charliemcohen/hab/photos/07_ground_test_rig.jpg

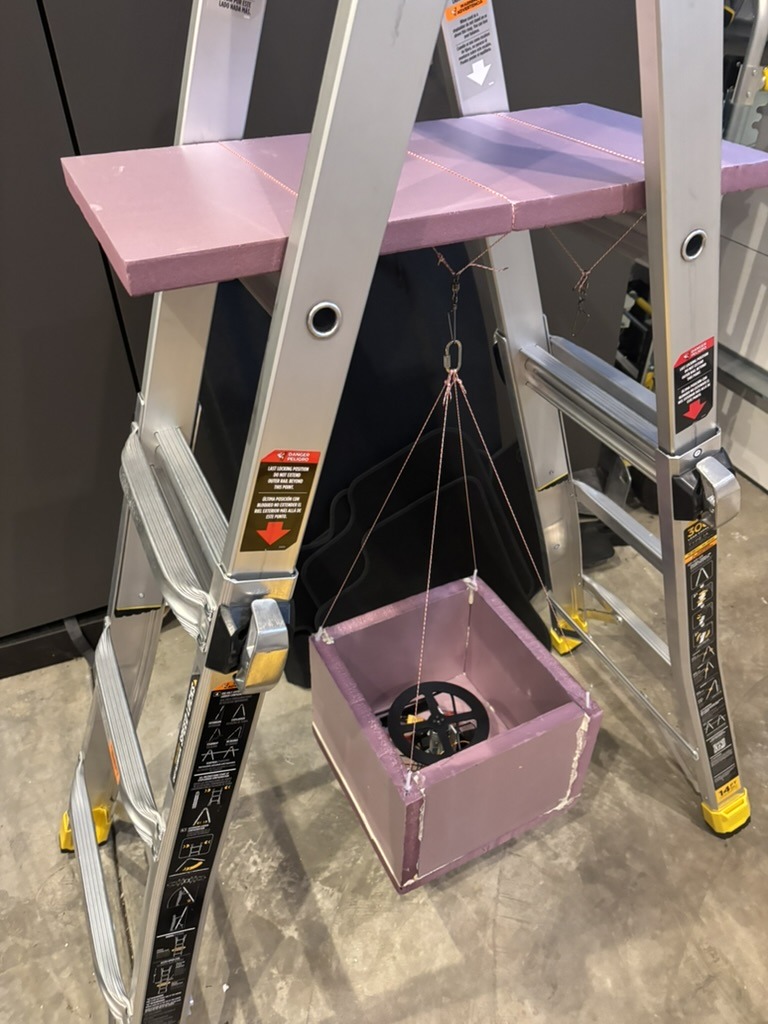
photos/07_ground_test_rig.jpg
