charliemcohen/hab/photos/05_electronics_closeup.jpg

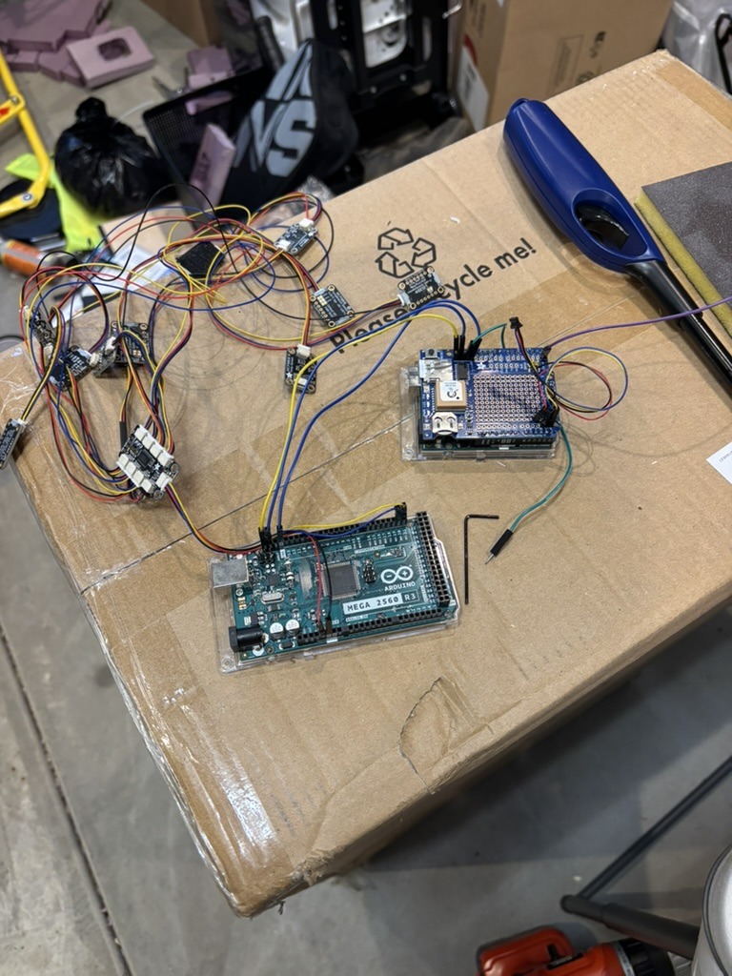
photos/05_electronics_closeup.jpg
