charliemcohen/hab/docs/figures/fig07_temperature_vs_altitude.png

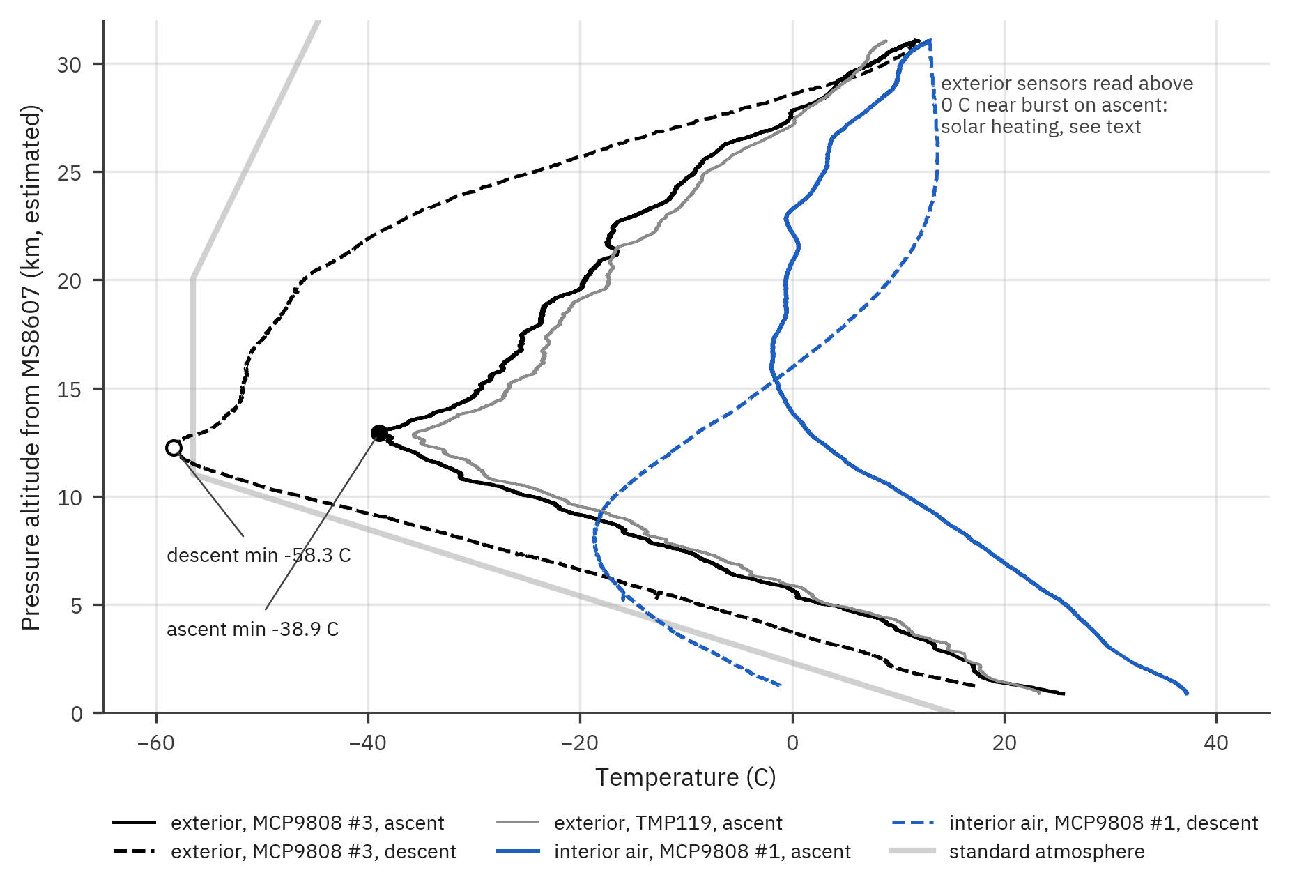
docs/figures/fig07_temperature_vs_altitude.png
