charliemcohen/hab/docs/figures/fig08_wind_vs_altitude.png

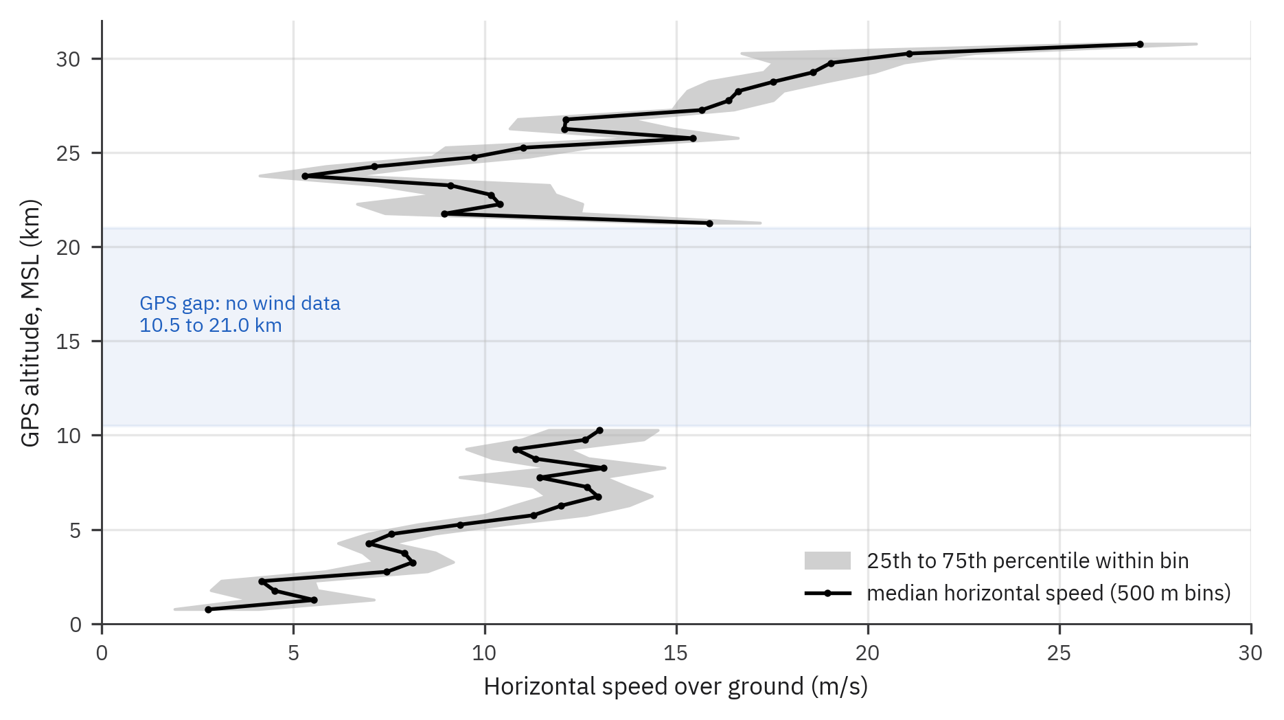
docs/figures/fig08_wind_vs_altitude.png
