charliemcohen/hab/docs/figures/fig11_light_uv_vs_altitude.png

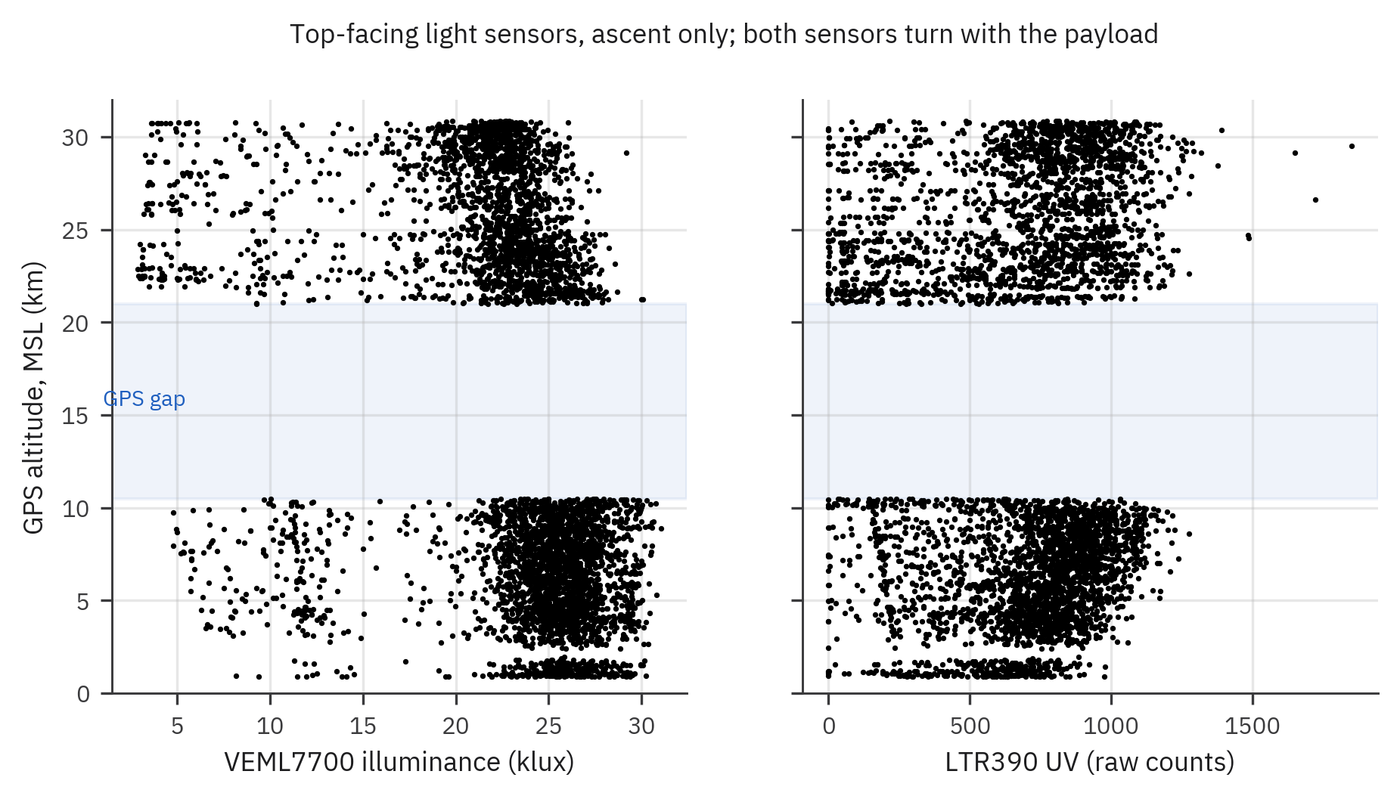
docs/figures/fig11_light_uv_vs_altitude.png
