charliemcohen/hab/photos/12_recovery_photo.jpg

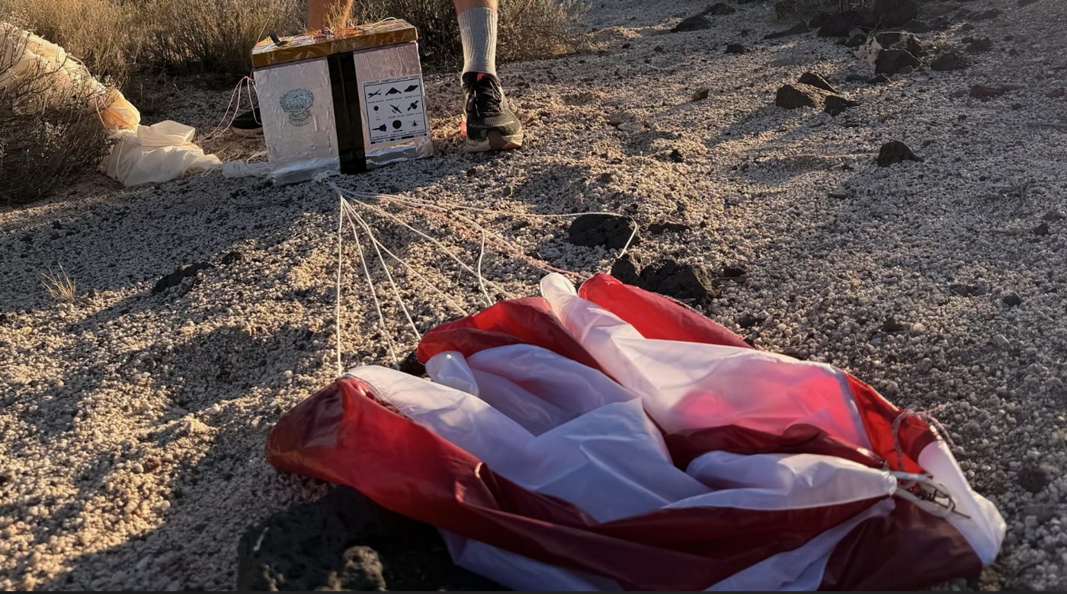
photos/12_recovery_photo.jpg
