charliemcohen/hab/rotation_results/Flight_2_rotation.csv

window | center | t_min | result | yaw_rate_dps | rot_per_min | method | repeat_period_s | repeat_strength | rpm_from_motion | implied_hfov_deg | swing_amplitude_deg | swing_period_s | direction | notes | plot
+0 min | 0:02:44.9 | 0.0 | swinging | 0.354 | 0.06 | net drift from frame motion, assumes hfov=120 deg | 4.45 | 0.52 | 0.06 |  | 28.3 | 102.0 | scene drifts right | 59% of frame pairs matched poorly (glare, blur, or tumbling) | rotation_results\Flight_2__0_min.png
+1 min | 0:02:49.9 | 1.0 | mixed | 0.506 | 0.08 | net drift from frame motion, assumes hfov=120 deg |  |  | 0.08 |  | 8.2 | 72.7 | scene drifts right | 100% of frame pairs matched poorly (glare, blur, or tumbling) | rotation_results\Flight_2__1_min.png
+2 min | 0:02:54.9 | 2.0 | nearly steady | 0.322 | 0.05 | frame motion, assumes hfov=120 deg | 38.46 | 0.48 | 0.05 |  | 9.2 | 179.9 | scene drifts right | 100% of frame pairs matched poorly (glare, blur, or tumbling) | rotation_results\Flight_2__2_min.png
+3 min | 0:02:59.9 | 3.0 | nearly steady | -0.118 | 0.02 | frame motion, assumes hfov=120 deg |  |  | 0.02 |  | 5.4 | 175.4 | scene drifts left | 100% of frame pairs matched poorly (glare, blur, or tumbling) | rotation_results\Flight_2__3_min.png
+4 min | 0:03:04.9 | 4.0 | nearly steady | -0.323 | 0.05 | frame motion, assumes hfov=120 deg | 50.33 | 0.72 | 0.05 |  | 5.1 | 56.7 | scene drifts left | 100% of frame pairs matched poorly (glare, blur, or tumbling) | rotation_results\Flight_2__4_min.png
+5 min | 0:03:09.9 | 5.0 | nearly steady | -0.05 | 0.01 | frame motion, assumes hfov=120 deg | 10.02 | 0.46 | 0.01 |  | 7.9 | 463.7 | scene drifts left | 100% of frame pairs matched poorly (glare, blur, or tumbling) | rotation_results\Flight_2__5_min.png
+6 min | 0:03:14.9 | 6.0 | nearly steady | 0.094 | 0.02 | frame motion, assumes hfov=120 deg |  |  | 0.02 |  | 4.9 | 81.9 | scene drifts right | 100% of frame pairs matched poorly (glare, blur, or tumbling) | rotation_results\Flight_2__6_min.png
+7 min | 0:03:19.9 | 7.0 | mixed | -0.34 | 0.06 | net drift from frame motion, assumes hfov=120 deg | 18.3 | 0.61 | 0.06 |  | 7.0 | 90.2 | scene drifts left | 100% of frame pairs matched poorly (glare, blur, or tumbling) | rotation_results\Flight_2__7_min.png
+8 min | 0:03:24.9 | 8.0 | nearly steady | -0.185 | 0.03 | frame motion, assumes hfov=120 deg |  |  | 0.03 |  | 4.2 | 22.3 | scene drifts left | 100% of frame pairs matched poorly (glare, blur, or tumbling) | rotation_results\Flight_2__8_min.png
+9 min | 0:03:29.9 | 9.0 | nearly steady | -0.094 | 0.02 | frame motion, assumes hfov=120 deg |  |  | 0.02 |  | 3.6 | 165.9 | scene drifts left | 100% of frame pairs matched poorly (glare, blur, or tumbling) | rotation_results\Flight_2__9_min.png
+10 min | 0:03:34.9 | 10.0 | nearly steady | 0.105 | 0.02 | frame motion, assumes hfov=120 deg | 51.53 | 0.49 | 0.02 |  | 5.4 | 38.6 | scene drifts right | 100% of frame pairs matched poorly (glare, blur, or tumbling) | rotation_results\Flight_2__10_min.png
+11 min | 0:03:39.9 | 11.0 | nearly steady | 0.148 | 0.02 | frame motion, assumes hfov=120 deg | 43.81 | 0.48 | 0.02 |  | 9.4 | 79.6 | scene drifts right | 100% of frame pairs matched poorly (glare, blur, or tumbling) | rotation_results\Flight_2__11_min.png
+12 min | 0:03:44.9 | 12.0 | nearly steady | -0.041 | 0.01 | frame motion, assumes hfov=120 deg |  |  | 0.01 |  | 7.7 | 170.6 | scene drifts left | 100% of frame pairs matched poorly (glare, blur, or tumbling) | rotation_results\Flight_2__12_min.png
+13 min | 0:03:49.9 | 13.0 | nearly steady | -0.15 | 0.02 | frame motion, assumes hfov=120 deg | 18.11 | 0.62 | 0.02 |  | 5.8 | 197.4 | scene drifts left | 100% of frame pairs matched poorly (glare, blur, or tumbling) | rotation_results\Flight_2__13_min.png
+14 min | 0:03:54.9 | 14.0 | nearly steady | -0.259 | 0.04 | frame motion, assumes hfov=120 deg | 49.62 | 0.68 | 0.04 |  | 5.5 | 34.2 | scene drifts left | 100% of frame pairs matched poorly (glare, blur, or tumbling) | rotation_results\Flight_2__14_min.png
+15 min | 0:03:59.9 | 15.0 | mixed | -0.401 | 0.07 | net drift from frame motion, assumes hfov=120 deg | 47.05 | 0.52 | 0.07 |  | 3.1 | 32.2 | scene drifts left | 100% of frame pairs matched poorly (glare, blur, or tumbling) | rotation_results\Flight_2__15_min.png
+16 min | 0:04:04.9 | 16.0 | nearly steady | 0.061 | 0.01 | frame motion, assumes hfov=120 deg | 40.36 | 0.61 | 0.01 |  | 8.9 | 145.8 | scene drifts right | 100% of frame pairs matched poorly (glare, blur, or tumbling) | rotation_results\Flight_2__16_min.png
+17 min | 0:04:09.9 | 17.0 | nearly steady | 0.097 | 0.02 | frame motion, assumes hfov=120 deg |  |  | 0.02 |  | 5.1 | 32.6 | scene drifts right | 100% of frame pairs matched poorly (glare, blur, or tumbling) | rotation_results\Flight_2__17_min.png
+18 min | 0:04:14.9 | 18.0 | nearly steady | -0.289 | 0.05 | frame motion, assumes hfov=120 deg | 41.61 | 0.51 | 0.05 |  | 4.1 | 209.3 | scene drifts left | 100% of frame pairs matched poorly (glare, blur, or tumbling) | rotation_results\Flight_2__18_min.png
+19 min | 0:04:19.9 | 19.0 | nearly steady | 0.096 | 0.02 | frame motion, assumes hfov=120 deg | 50.11 | 0.69 | 0.02 |  | 8.5 | 147.1 | scene drifts right | 100% of frame pairs matched poorly (glare, blur, or tumbling) | rotation_results\Flight_2__19_min.png
+20 min | 0:04:24.9 | 20.0 | nearly steady | 0.166 | 0.03 | frame motion, assumes hfov=120 deg | 43.87 | 0.72 | 0.03 |  | 4.9 | 117.8 | scene drifts right | 100% of frame pairs matched poorly (glare, blur, or tumbling) | rotation_results\Flight_2__20_min.png
+21 min | 0:04:29.9 | 21.0 | nearly steady | 0.278 | 0.05 | frame motion, assumes hfov=120 deg |  |  | 0.05 |  | 5.8 | 102.1 | scene drifts right | 100% of frame pairs matched poorly (glare, blur, or tumbling) | rotation_results\Flight_2__21_min.png
+22 min | 0:04:34.9 | 22.0 | nearly steady | 0.059 | 0.01 | frame motion, assumes hfov=120 deg | 57.01 | 0.54 | 0.01 |  | 7.8 | 85.5 | scene drifts right | 100% of frame pairs matched poorly (glare, blur, or tumbling) | rotation_results\Flight_2__22_min.png
+23 min | 0:04:39.9 | 23.0 | mixed | 0.405 | 0.07 | net drift from frame motion, assumes hfov=120 deg | 28.6 | 0.47 | 0.07 |  | 3.9 | 77.5 | scene drifts right | 100% of frame pairs matched poorly (glare, blur, or tumbling) | rotation_results\Flight_2__23_min.png
+24 min | 0:04:44.9 | 24.0 | nearly steady | 0.026 | 0.0 | frame motion, assumes hfov=120 deg |  |  | 0.0 |  | 6.9 | 69.5 | scene drifts right | 100% of frame pairs matched poorly (glare, blur, or tumbling) | rotation_results\Flight_2__24_min.png
+25 min | 0:04:49.9 | 25.0 | nearly steady | 0.141 | 0.02 | frame motion, assumes hfov=120 deg | 16.36 | 0.53 | 0.02 |  | 5.7 | 98.8 | scene drifts right | 100% of frame pairs matched poorly (glare, blur, or tumbling) | rotation_results\Flight_2__25_min.png
+26 min | 0:04:54.9 | 26.0 | nearly steady | -0.269 | 0.04 | frame motion, assumes hfov=120 deg |  |  | 0.04 |  | 9.7 | 97.0 | scene drifts left | 100% of frame pairs matched poorly (glare, blur, or tumbling) | rotation_results\Flight_2__26_min.png
+27 min | 0:04:59.9 | 27.0 | mixed | 0.175 | 0.03 | net drift from frame motion, assumes hfov=120 deg | 27.82 | 0.46 | 0.03 |  | 11.3 | 148.4 | scene drifts right | 100% of frame pairs matched poorly (glare, blur, or tumbling) | rotation_results\Flight_2__27_min.png
+28 min | 0:05:04.9 | 28.0 | swinging | -0.102 | 0.02 | net drift from frame motion, assumes hfov=120 deg | 17.64 | 0.47 | 0.02 |  | 10.1 | 282.5 | scene drifts left | 100% of frame pairs matched poorly (glare, blur, or tumbling) | rotation_results\Flight_2__28_min.png
+29 min | 0:05:09.9 | 29.0 | swinging | -0.053 | 0.01 | net drift from frame motion, assumes hfov=120 deg |  |  | 0.01 |  | 11.1 | 247.0 | scene drifts left | 100% of frame pairs matched poorly (glare, blur, or tumbling) | rotation_results\Flight_2__29_min.png
+30 min | 0:05:14.9 | 30.0 | nearly steady | 0.312 | 0.05 | frame motion, assumes hfov=120 deg | 25.96 | 0.49 | 0.05 |  | 4.5 | 29.4 | scene drifts right | 100% of frame pairs matched poorly (glare, blur, or tumbling) | rotation_results\Flight_2__30_min.png
