charliemcohen/hab/rotation_results/Flight_2_upper_rotation.csv

window | center | t_min | result | yaw_rate_dps | rot_per_min | method | repeat_period_s | repeat_strength | rpm_from_motion | implied_hfov_deg | swing_amplitude_deg | swing_period_s | direction | notes | plot
+30 min | 0:05:14.9 | 30.0 | nearly steady | 0.312 | 0.05 | frame motion, assumes hfov=120 deg | 25.96 | 0.49 | 0.05 |  | 4.5 | 29.4 | scene drifts right | 100% of frame pairs matched poorly (glare, blur, or tumbling) | rotation_results\Flight_2_upper__30_min.png
+35 min | 0:05:39.9 | 35.0 | mixed | -0.325 | 0.05 | net drift from frame motion, assumes hfov=120 deg | 47.28 | 0.48 | 0.05 |  | 13.1 | 273.6 | scene drifts left | 100% of frame pairs matched poorly (glare, blur, or tumbling) | rotation_results\Flight_2_upper__35_min.png
+40 min | 0:06:04.9 | 40.0 | swinging | -0.171 | 0.03 | net drift from frame motion, assumes hfov=120 deg |  |  | 0.03 |  | 10.3 | 271.7 | scene drifts left | 100% of frame pairs matched poorly (glare, blur, or tumbling) | rotation_results\Flight_2_upper__40_min.png
+45 min | 0:06:29.9 | 45.0 | swinging | -0.235 | 0.04 | net drift from frame motion, assumes hfov=120 deg | 29.74 | 0.49 | 0.04 |  | 12.1 | 644.5 | scene drifts left | 100% of frame pairs matched poorly (glare, blur, or tumbling) | rotation_results\Flight_2_upper__45_min.png
+50 min | 0:06:54.9 | 50.0 | nearly steady | -0.116 | 0.02 | frame motion, assumes hfov=120 deg | 5.83 | 0.65 | 0.02 |  | 5.3 | 86.1 | scene drifts left | 100% of frame pairs matched poorly (glare, blur, or tumbling) | rotation_results\Flight_2_upper__50_min.png
+55 min | 0:07:19.9 | 55.0 | nearly steady | -0.053 | 0.01 | frame motion, assumes hfov=120 deg |  |  | 0.01 |  | 8.0 | 174.4 | scene drifts left | 100% of frame pairs matched poorly (glare, blur, or tumbling) | rotation_results\Flight_2_upper__55_min.png
+60 min | 0:07:44.9 | 60.0 | mixed | -0.374 | 0.06 | net drift from frame motion, assumes hfov=120 deg | 34.27 | 0.82 | 0.06 |  | 3.6 | 38.7 | scene drifts left | 100% of frame pairs matched poorly (glare, blur, or tumbling) | rotation_results\Flight_2_upper__60_min.png
+65 min | 0:08:09.9 | 65.0 | nearly steady | 0.025 | 0.0 | frame motion, assumes hfov=120 deg |  |  | 0.0 |  | 5.0 | 52.3 | scene drifts right | 100% of frame pairs matched poorly (glare, blur, or tumbling) | rotation_results\Flight_2_upper__65_min.png
+70 min | 0:08:34.9 | 70.0 | nearly steady | 0.001 | 0.0 | frame motion, assumes hfov=120 deg | 51.12 | 0.51 | 0.0 |  | 9.0 | 185.0 | scene drifts right | 100% of frame pairs matched poorly (glare, blur, or tumbling) | rotation_results\Flight_2_upper__70_min.png
+75 min | 0:08:59.9 | 75.0 | nearly steady | -0.11 | 0.02 | frame motion, assumes hfov=120 deg |  |  | 0.02 |  | 4.4 | 124.3 | scene drifts left | 100% of frame pairs matched poorly (glare, blur, or tumbling) | rotation_results\Flight_2_upper__75_min.png
+80 min | 0:09:24.9 | 80.0 | mixed | -0.358 | 0.06 | net drift from frame motion, assumes hfov=120 deg |  |  | 0.06 |  | 8.9 | 183.2 | scene drifts left | 100% of frame pairs matched poorly (glare, blur, or tumbling) | rotation_results\Flight_2_upper__80_min.png
+85 min | 0:09:49.9 | 85.0 | nearly steady | 0.073 | 0.01 | frame motion, assumes hfov=120 deg |  |  | 0.01 |  | 3.0 | 70.7 | scene drifts right | 100% of frame pairs matched poorly (glare, blur, or tumbling) | rotation_results\Flight_2_upper__85_min.png
+90 min | 0:10:14.9 | 90.0 | nearly steady | -0.034 | 0.01 | frame motion, assumes hfov=120 deg |  |  | 0.01 |  | 4.3 | 117.2 | scene drifts left | 100% of frame pairs matched poorly (glare, blur, or tumbling) | rotation_results\Flight_2_upper__90_min.png
+95 min | 0:10:39.9 | 95.0 | nearly steady | 0.282 | 0.05 | frame motion, assumes hfov=120 deg | 40.47 | 0.73 | 0.05 |  | 3.4 | 40.6 | scene drifts right | 100% of frame pairs matched poorly (glare, blur, or tumbling) | rotation_results\Flight_2_upper__95_min.png
