charliemcohen/hab/rotation_results/Flight_2__4_min.png

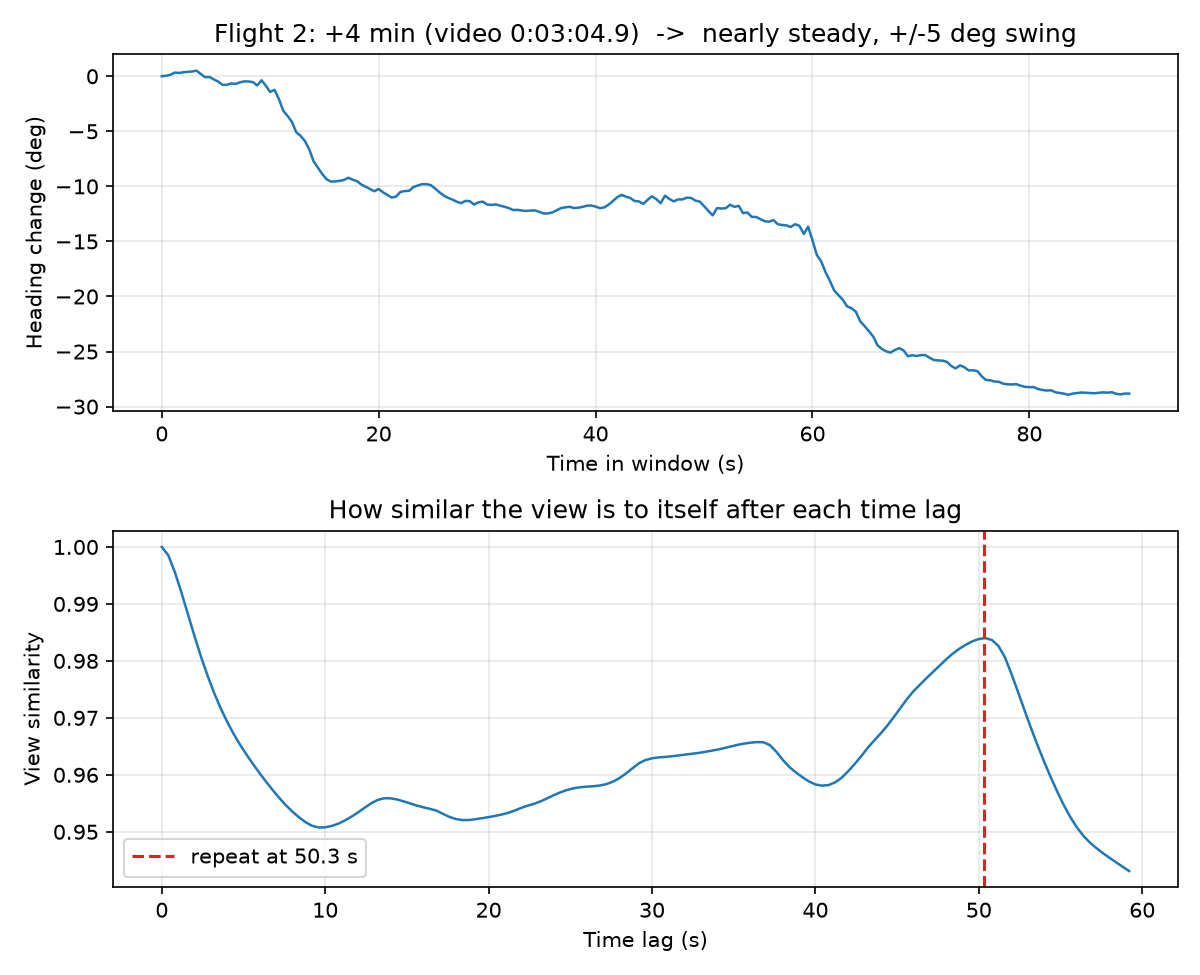
rotation_results/Flight_2__4_min.png
