charliemcohen/hab/rotation_results/Flight_2__14_min.png

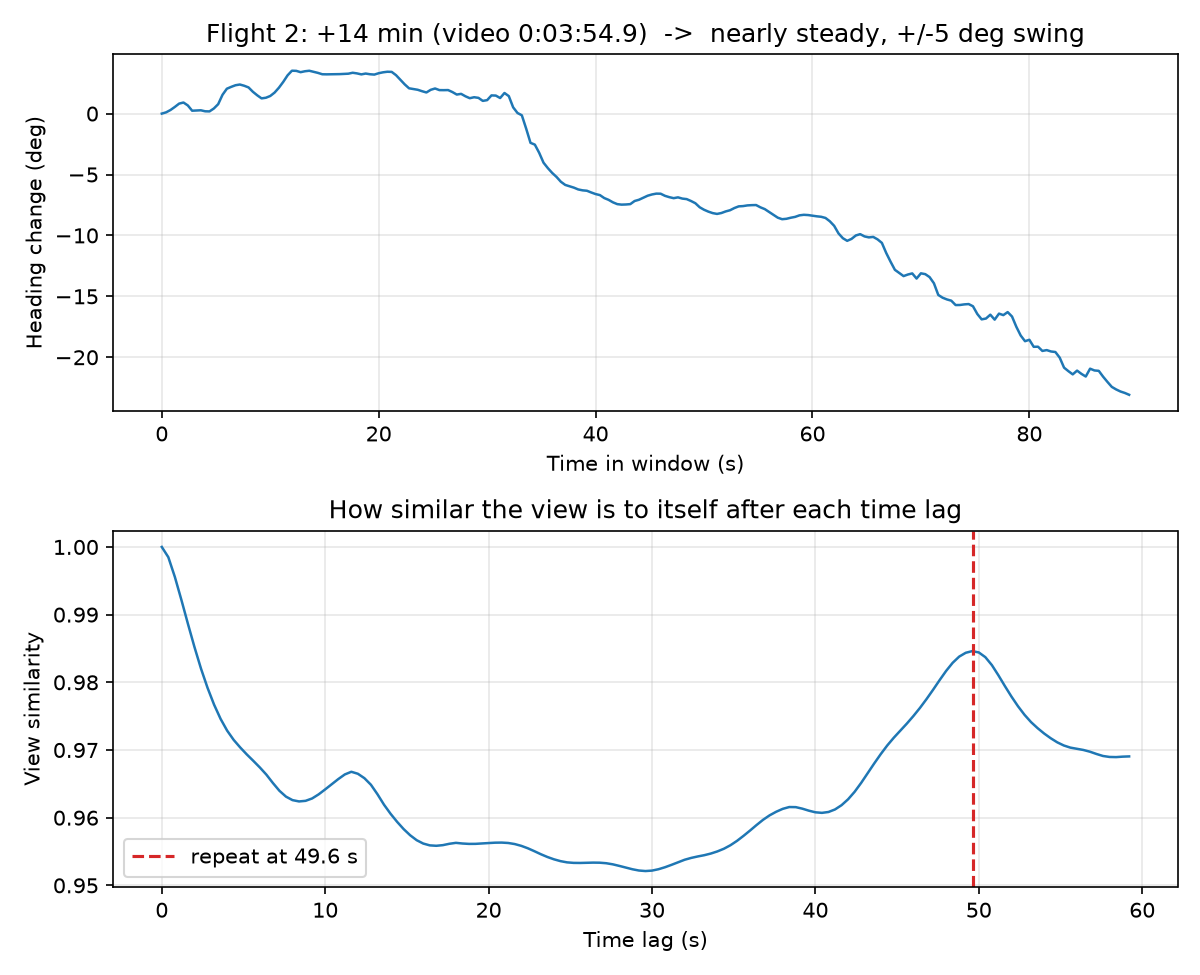
rotation_results/Flight_2__14_min.png
